marckson/tree-christimas/DOCS/minha-arvore-fotos/SDC10050.JPG

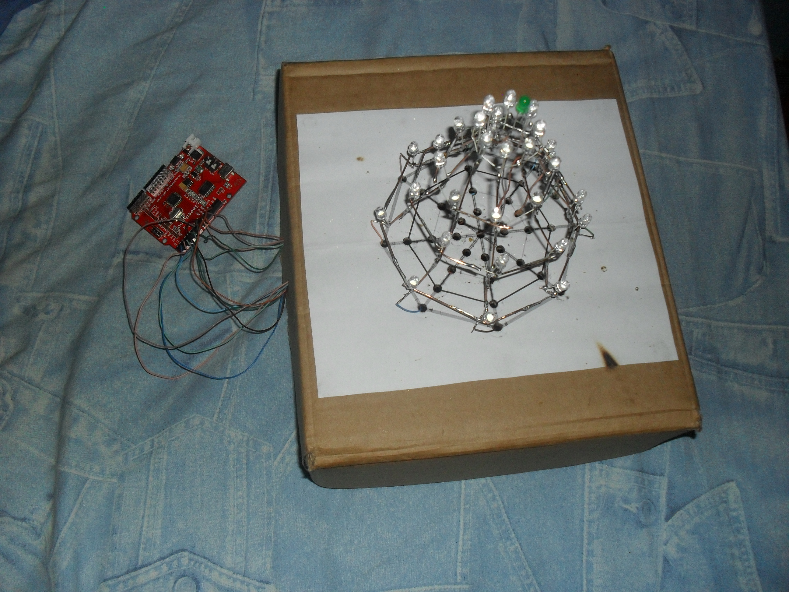
DOCS/minha-arvore-fotos/SDC10050.JPG
