marckson/tree-christimas/DOCS/minha-arvore-fotos/SDC10045.JPG

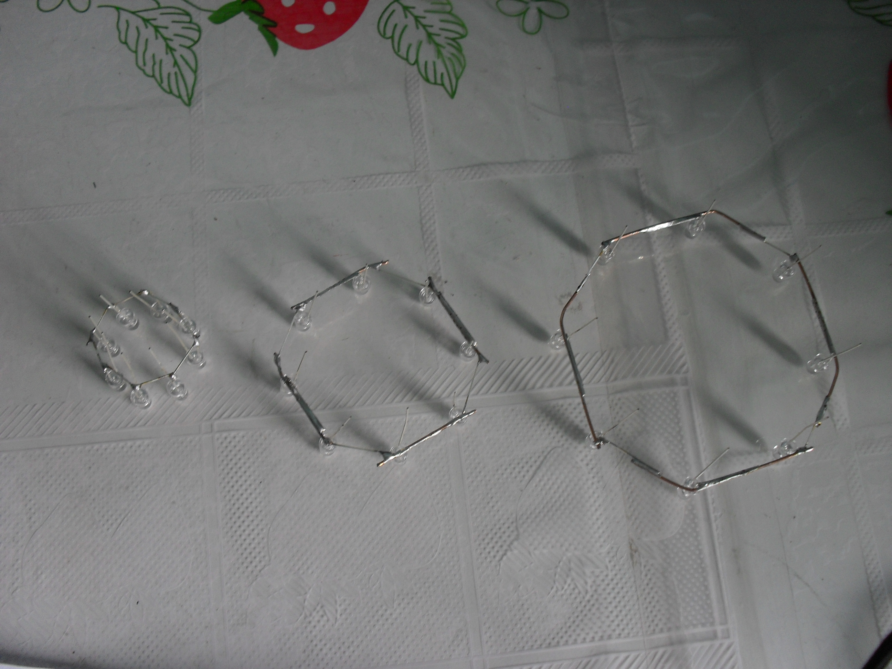
DOCS/minha-arvore-fotos/SDC10045.JPG
