marckson/tree-christimas/DOCS/minha-arvore-fotos/SDC10044.JPG

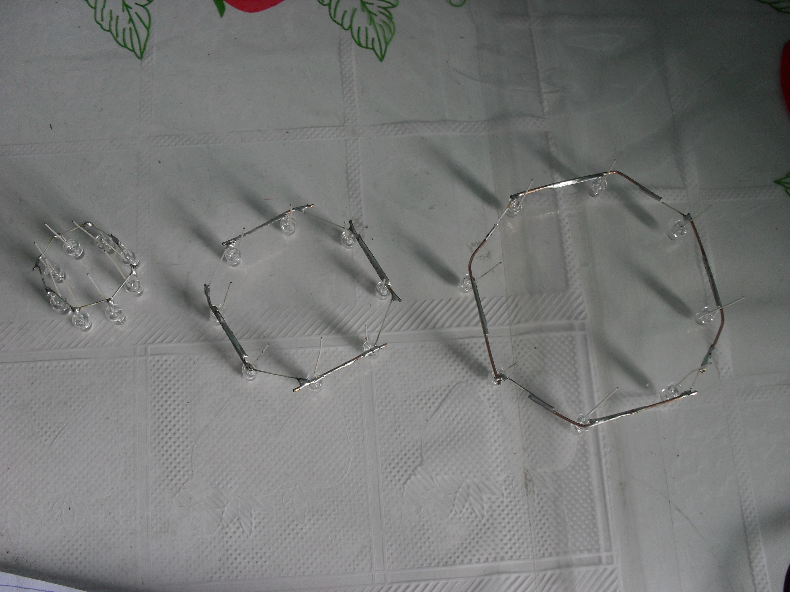
DOCS/minha-arvore-fotos/SDC10044.JPG
