marckson/tree-christimas/DOCS/minha-arvore-fotos/SDC10046.JPG

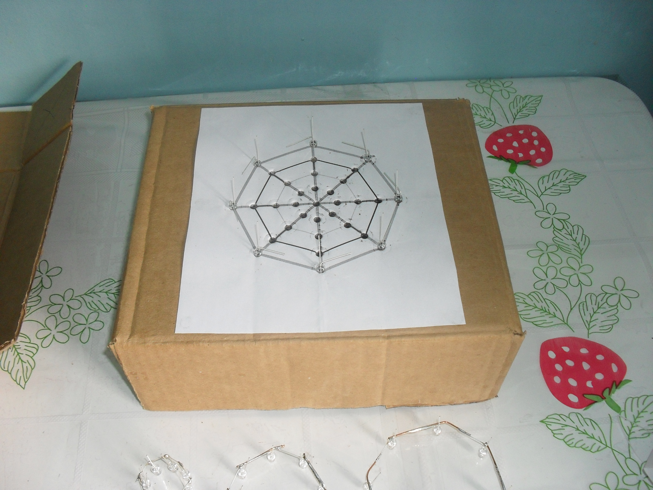
DOCS/minha-arvore-fotos/SDC10046.JPG
