marckson/tree-christimas/DOCS/minha-arvore-fotos/SDC10047.JPG

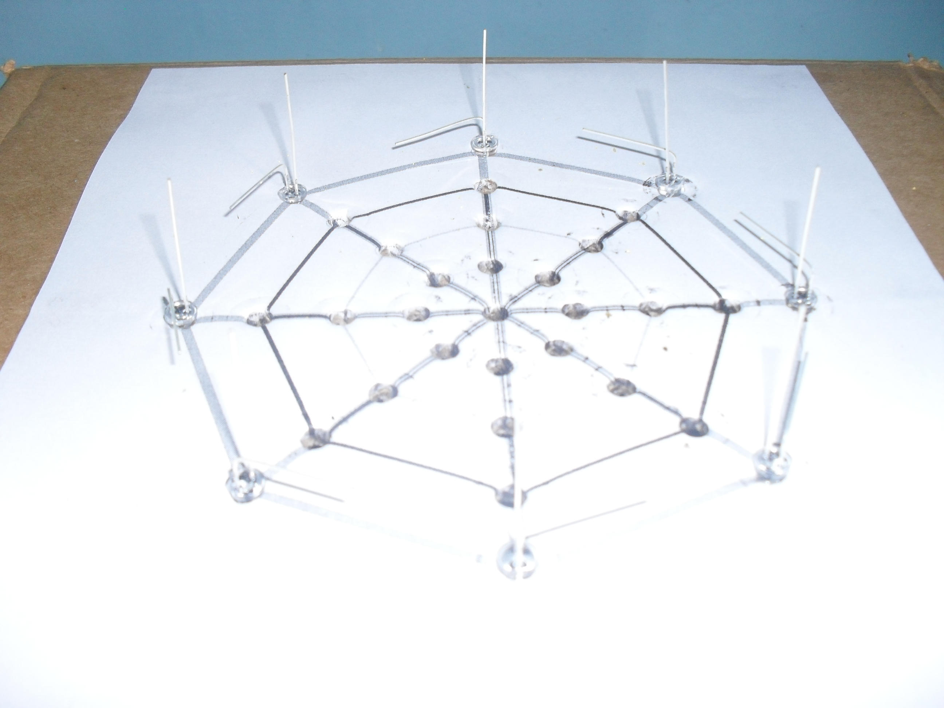
DOCS/minha-arvore-fotos/SDC10047.JPG
