marckson/tree-christimas/DOCS/minha-arvore-fotos/SDC10048.JPG

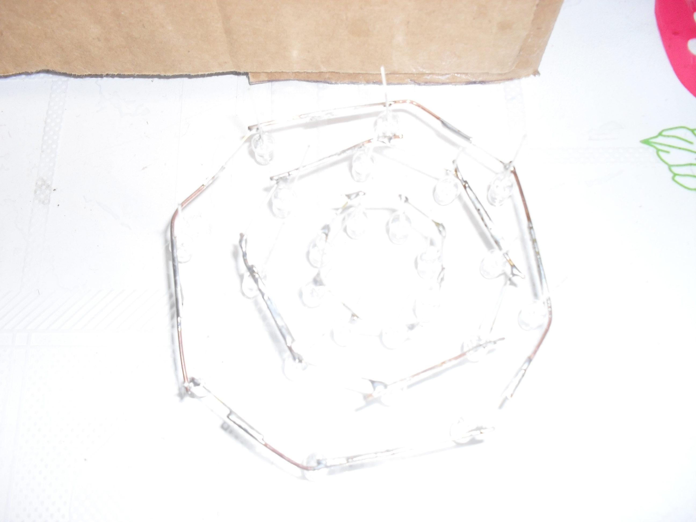
DOCS/minha-arvore-fotos/SDC10048.JPG
