marckson/tree-christimas/DOCS/minha-arvore-fotos/SDC10049.JPG

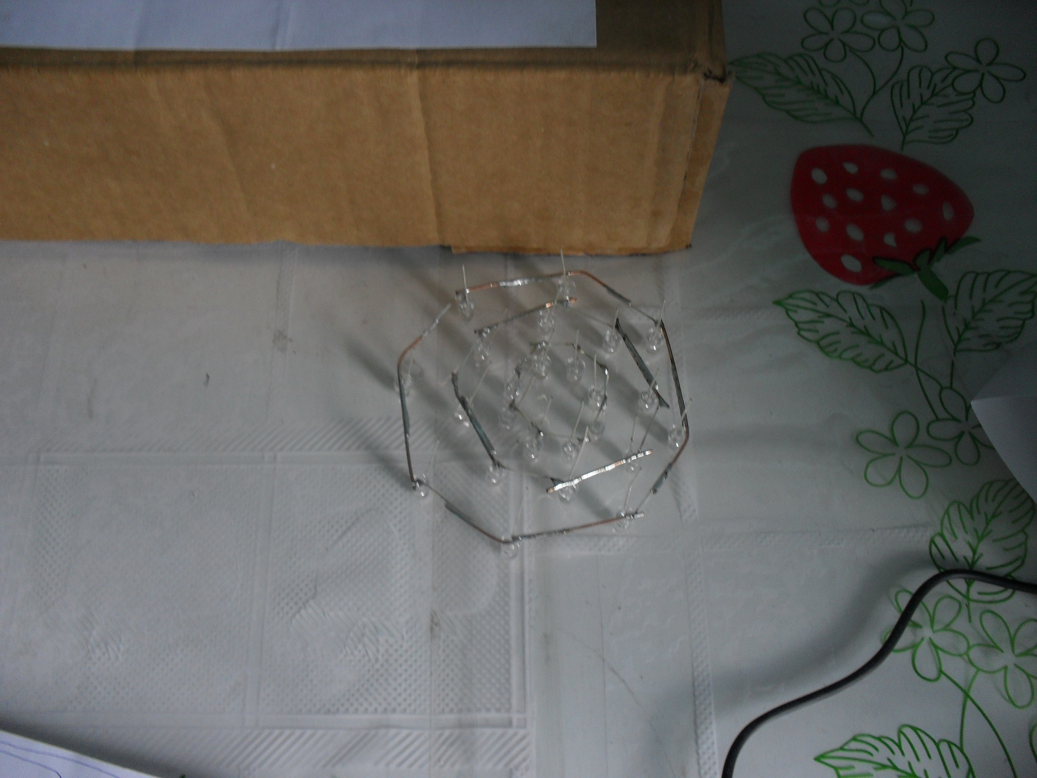
DOCS/minha-arvore-fotos/SDC10049.JPG
