marckson/tree-christimas/DOCS/minha-arvore-fotos/SDC10051.JPG

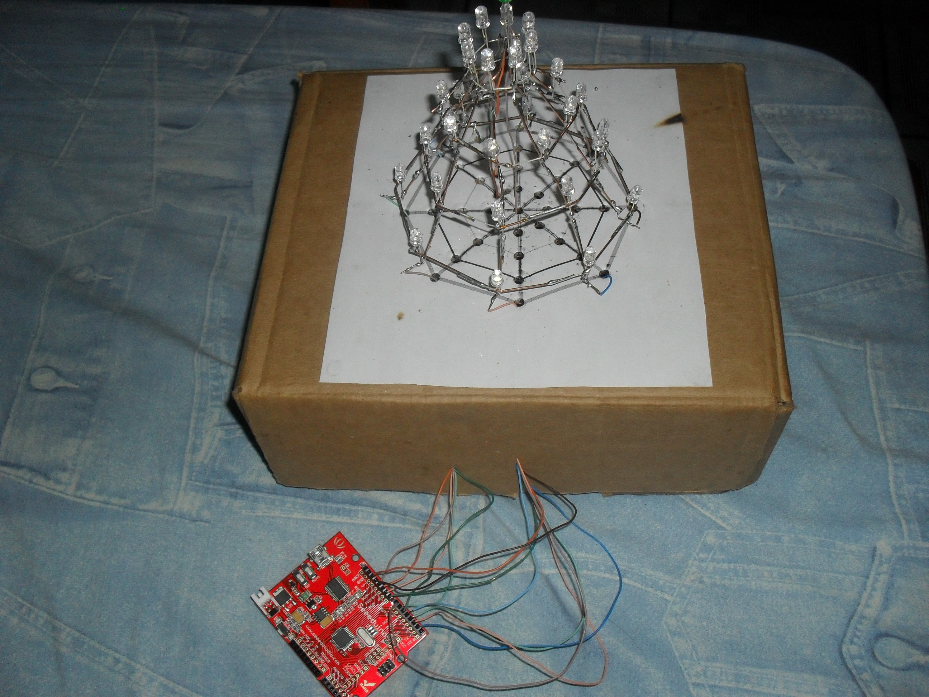
DOCS/minha-arvore-fotos/SDC10051.JPG
